HarryHeywood04/RobotDog/images/dog.jpeg

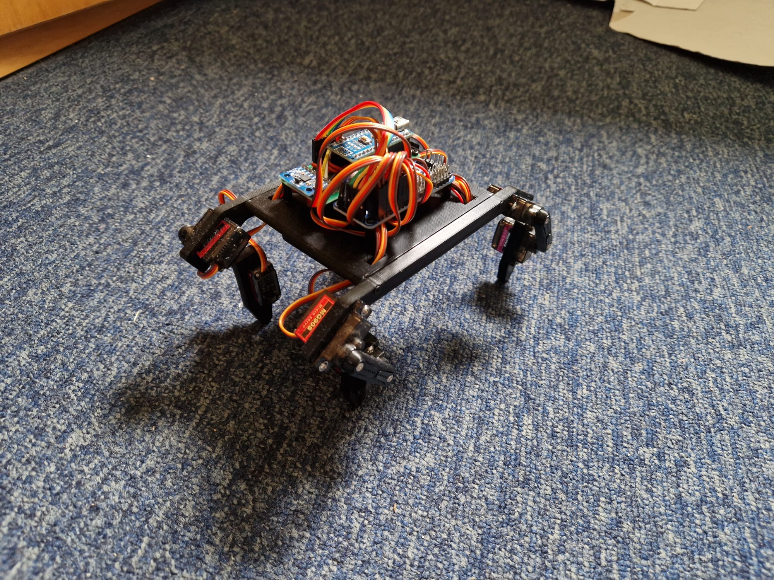
images/dog.jpeg
