HarryHeywood04/RobotDog/images/side.jpeg

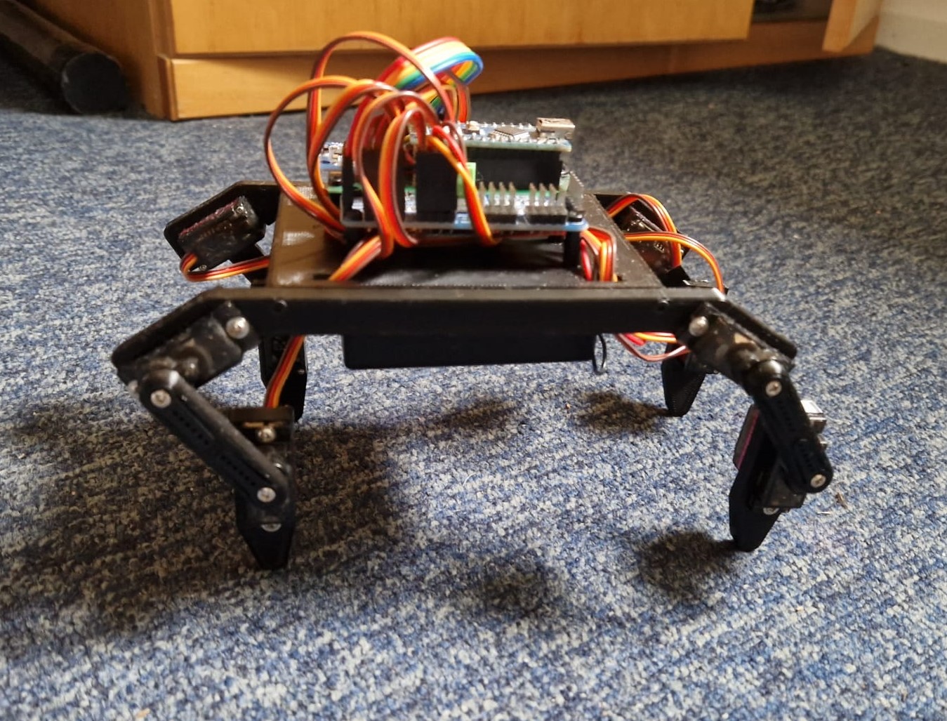
images/side.jpeg
