HarryHeywood04/RobotDog/Design Files/Schematic.png

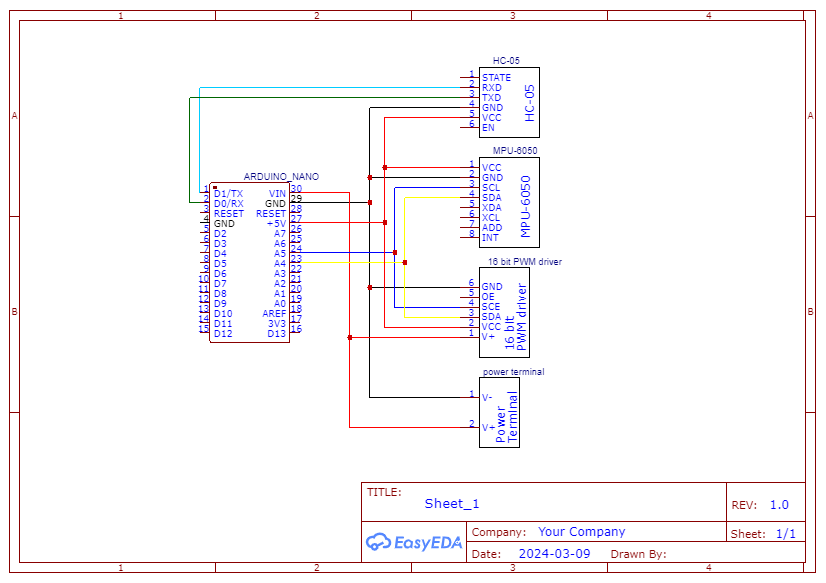
Design Files/Schematic.png
