HarryHeywood04/RobotDog/Design Files/Products List.xlsx

Product | Amount | Price | Link | I DO NOT RECEIVE ANY COMMISION FROM THESE LINKS, THEY ARE JUST WHERE I GOT MY PARTS FROM
MG90 Servo Motor | 8 | £23.20 | here (https://kunkune.co.uk/shop/best-sellers/servo-motor-mg90-metal-gear/) | PRICES MAY HAVE CHANGED
Arduino Nano | 1 | £5.90 | here (https://kunkune.co.uk/shop/on-sale/arduino-nano-v3-0-compatible-atmega328p/)
16 channel PWM driver | 1 | £5.90 | here (https://kunkune.co.uk/shop/uncategorized/pca9685pw-16-channel-i2c-servo-shield-and-led-pwm-driver-board-for-raspberry/)
MPU-6050 | 1 | £3.45 | here (https://kunkune.co.uk/shop/arduino-sensors/mpu-6050-3-axis-analog-gyroscope-accelerometer/)
HC-05 Bluetooth module | 1 | £3.90 | here (https://kunkune.co.uk/shop/communication-boards/4pin-hc-05-hc-06-bluetooth-wireless-serial-transceiver-module/)
4 X AA battery holder | 1 | £3.75 | here (https://www.amazon.co.uk/gp/product/B00UNH4MLS/ref=ppx_yo_dt_b_asin_title_o08_s00?ie=UTF8&psc=1)
M2 threaded insert | N/A | £6.59 | here (https://www.amazon.co.uk/gp/product/B0B8GN63S2/ref=ppx_yo_dt_b_asin_title_o07_s00?ie=UTF8&psc=1)
M2 machine screws | N/A | £6.99 | here (https://www.amazon.co.uk/gp/product/B0B7JLDV6V/ref=ppx_yo_dt_b_asin_title_o07_s00?ie=UTF8&psc=1)
M2 standoffs + bolts | N/A | £14.99 | here (https://www.amazon.co.uk/gp/product/B097LGSKXG/ref=ppx_yo_dt_b_asin_title_o02_s01?ie=UTF8&psc=1)
Prototype Board | N/A | £11.99 | here (https://www.amazon.co.uk/gp/product/B093KMB6PK/ref=ppx_yo_dt_b_asin_title_o00_s01?ie=UTF8&psc=1)
Solid core wire | N/A | £15.99 | here (https://www.amazon.co.uk/gp/product/B07V5FVSYL/ref=ppx_yo_dt_b_asin_title_o07_s00?ie=UTF8&psc=1)
Breadboard jumper cables | N/A | £6.99 | here (https://www.amazon.co.uk/gp/product/B01EV70C78/ref=ppx_yo_dt_b_asin_title_o03_s00?ie=UTF8&psc=1)
TOTAL: |  | £109.64
Not included:
3D printer filament
Velcro to attach battery pack
