HarryHeywood04/RobotDog/Design Files/3D Files/Leg X4.stl

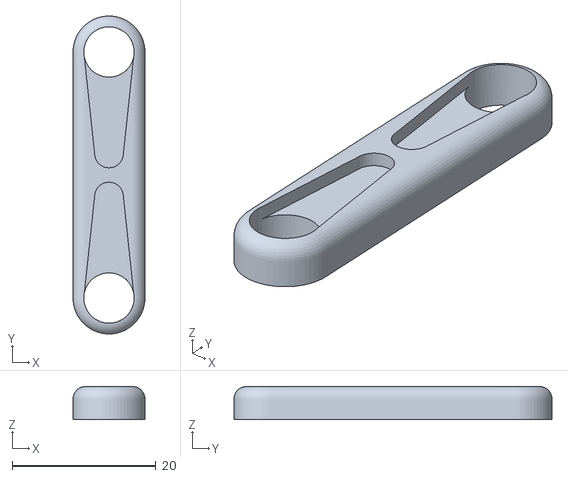
[picture p4: CAD file, 2023-10-28]
Design Files/3D Files/Leg X4.stl
10.0 x 44.2 x 4.60
