HarryHeywood04/RobotDog/Design Files/3D Files/Foot X4.stl

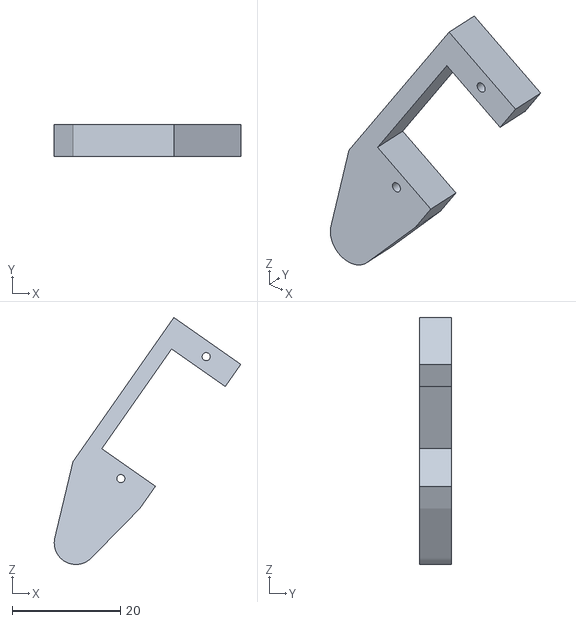
[picture p5: CAD file, 2023-10-28]
Design Files/3D Files/Foot X4.stl
34.5 x 6.00 x 45.6
