HarryHeywood04/RobotDog/Design Files/3D Files/Hip X2.stl

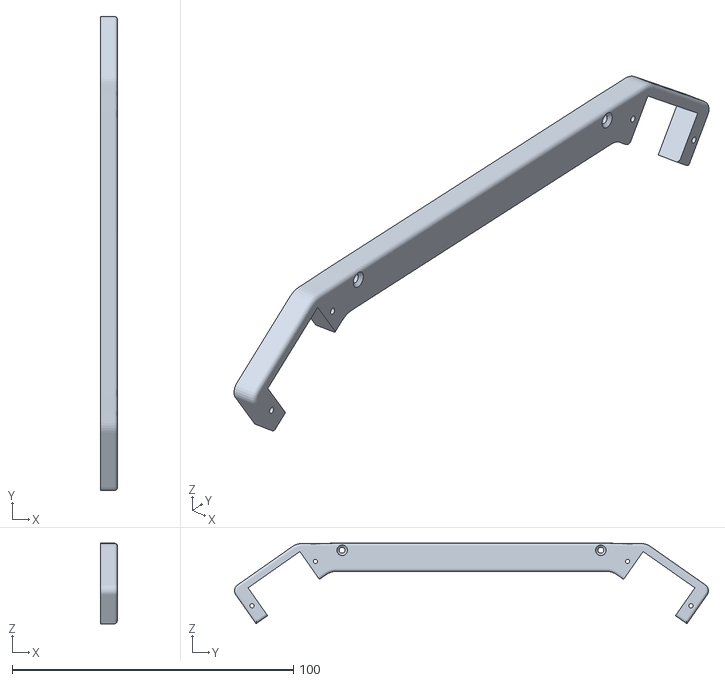
[picture p6: CAD file, 2023-10-28]
Design Files/3D Files/Hip X2.stl
6.00 x 168.6 x 28.6
