HarryHeywood04/RobotDog/Design Files/3D Files/Body X1.stl

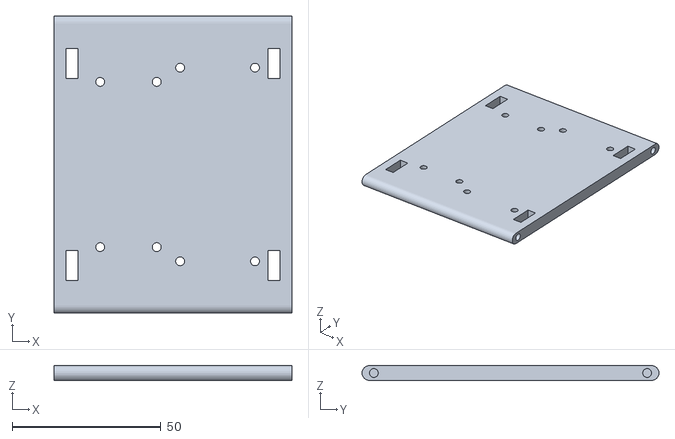
[picture p7: CAD file, 2023-10-28]
Design Files/3D Files/Body X1.stl
80.0 x 100.0 x 5.00
