HarryHeywood04/RobotDog/(commit log)

2023-10-28 Update to project
    The initial files for the project
    [Body X1.stl, Foot X4.stl, Hip X2.stl, Leg X4.stl, Products List.xlsx]
2024-03-09 Combined calibration into main and created an app to communicate with it
    A huge update including an android app that can be used to calibrate the robot. Added a HC-05 module to the bot to communicate with the phone.
2024-03-09 Added electronics schematic
    [Products List.xlsx]
